Cogusue/Testador_de_AMP-OP/Simulações e Kikad/README.md

# Informações
Esta pasta contem as simulações e o o arquivo Kikad do projeto, que contém o esquematico e PCB do circuito.
Dado o proteus não sendo um bom software para simular circuitos analogicos, não simulei o oscilador nele. Houve certos erros por conta das não idealidades do circuito, que não fariam sentido o uso no proteus.
