Cogusue/Testador_de_AMP-OP/Imagens/README.md

# Informações
Estas são as imagens do esquematico e o flowchart do projeto.
Na pasta há imagens e videos das montagens.
