Cogusue/Testador_de_AMP-OP/Imagens/Read_Me.md

#Informações
Estas são as imagens e prints, feitas e tirados, durante o percurso do projeto.
