Cogusue/Testador_de_AMP-OP/(list of files, drawings)

Other design files:
Simulações e Kikad/Testador de Amp-OP (Sem Oscilador).pdsprj
