Cogusue/Testador_de_AMP-OP/Imagens/Montagem/README.md

# Informações
Fotos retiradas durante a montagem e e teste do projeto.
