Cogusue/Testador_de_AMP-OP/Imagens/Montagem/20220411_125517.jpg

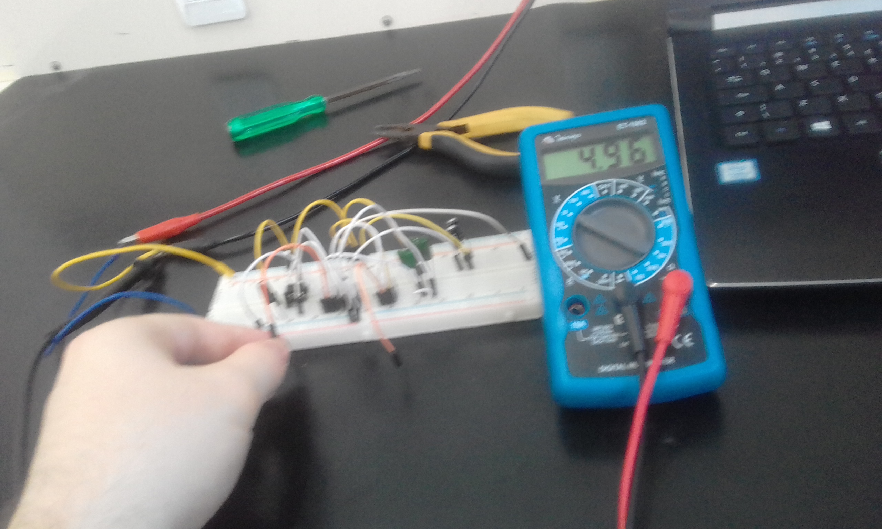
Imagens/Montagem/20220411_125517.jpg
