Cogusue/Testador_de_AMP-OP/Imagens/Montagem/20220411_125523.jpg

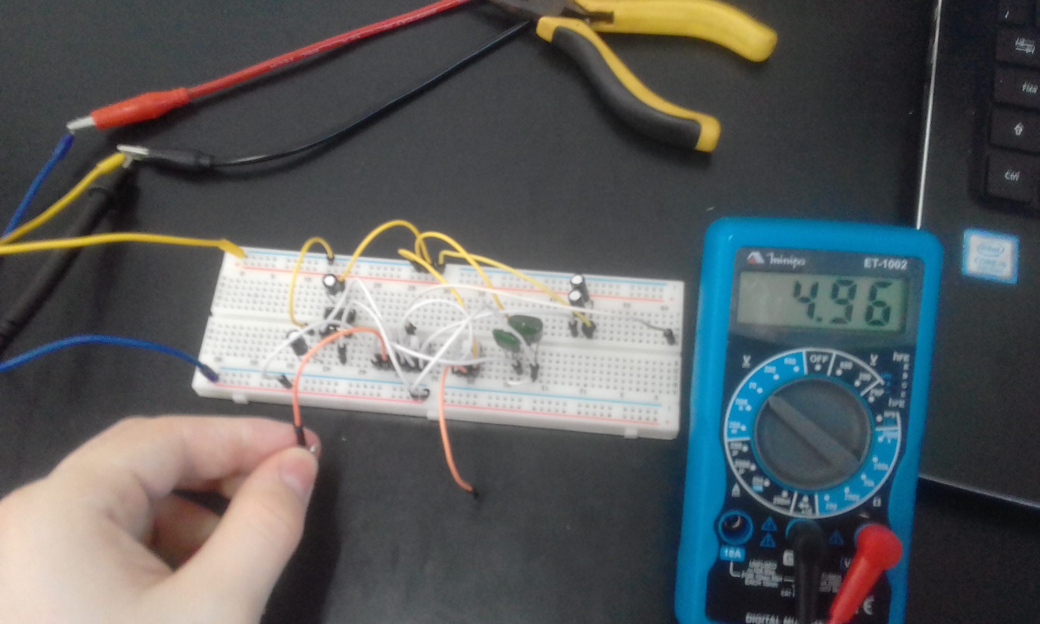
Imagens/Montagem/20220411_125523.jpg
