Cogusue/Testador_de_AMP-OP/Imagens/Montagem/20220427_115326.jpg

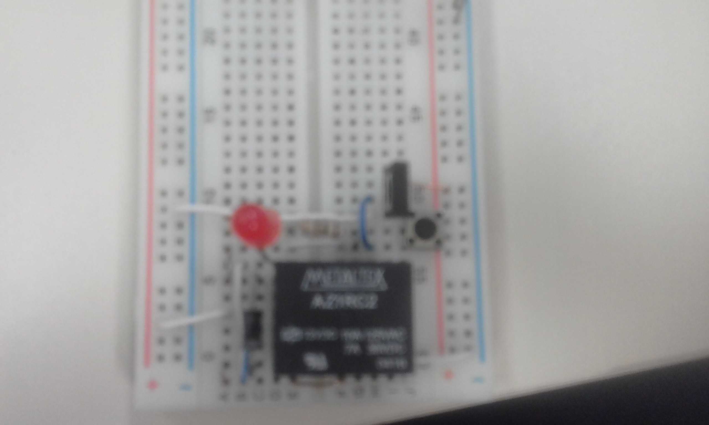
Imagens/Montagem/20220427_115326.jpg
