Cogusue/Testador_de_AMP-OP/Imagens/Montagem/20220427_115338.jpg

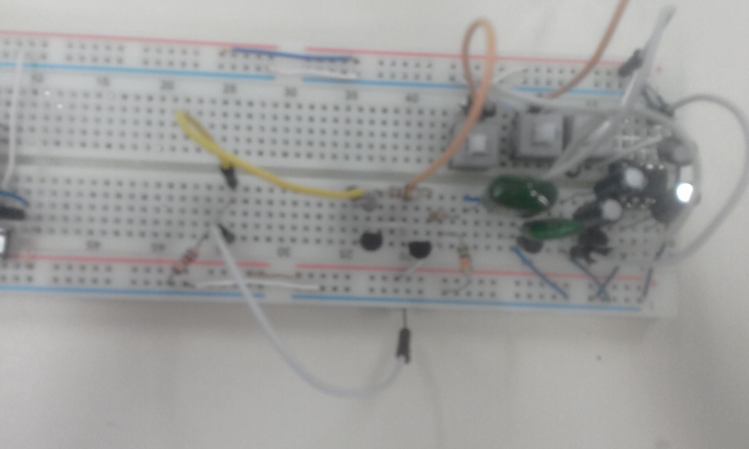
Imagens/Montagem/20220427_115338.jpg
