Cogusue/Testador_de_AMP-OP/Imagens/Montagem/20220427_115400.jpg

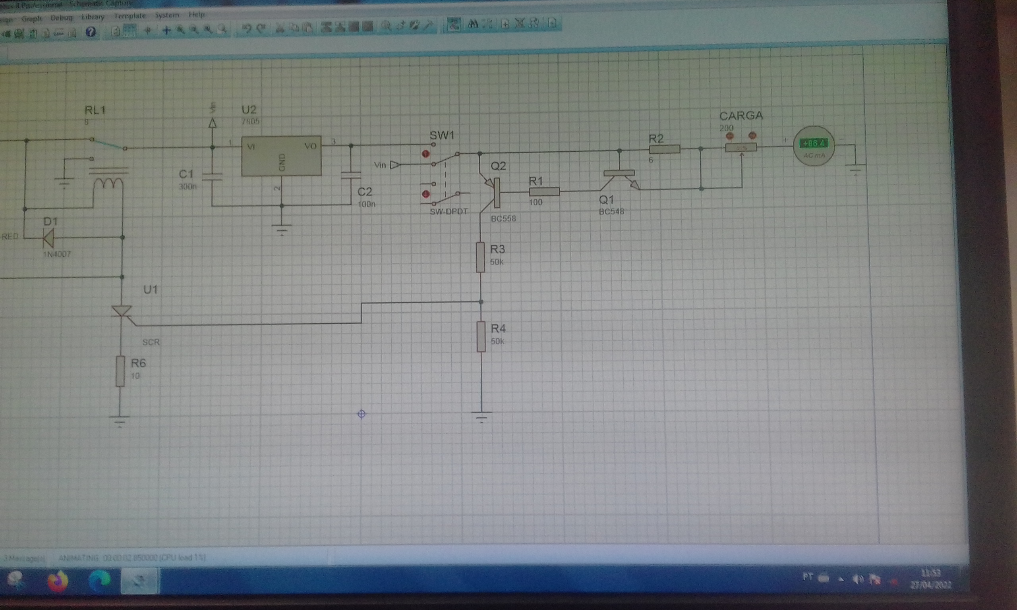
Imagens/Montagem/20220427_115400.jpg
