Cogusue/Testador_de_AMP-OP/Imagens/Montagem/20220503_115729.jpg

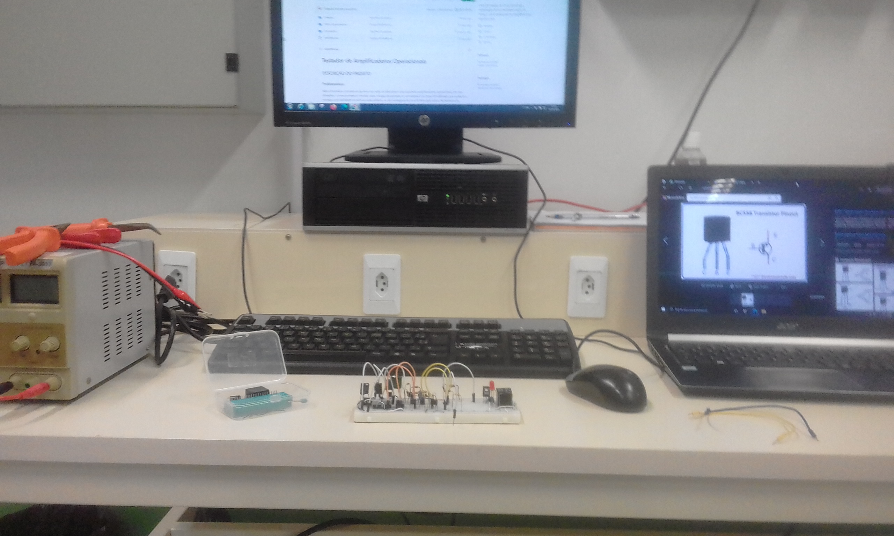
Imagens/Montagem/20220503_115729.jpg
