Cogusue/Testador_de_AMP-OP/Imagens/Montagem/20220517_095759.jpg

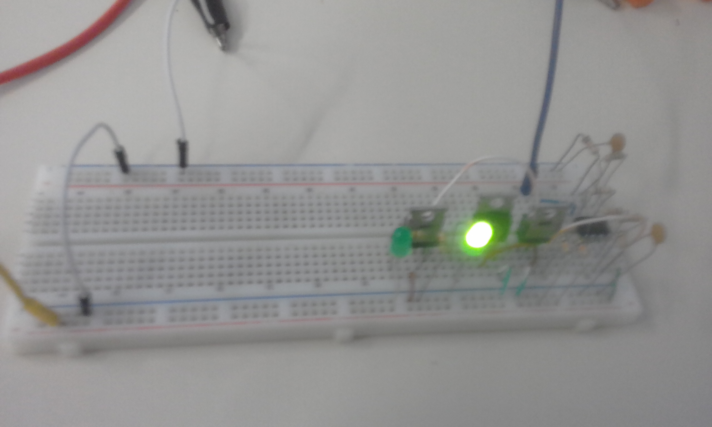
Imagens/Montagem/20220517_095759.jpg
