Cogusue/Testador_de_AMP-OP/Imagens/Montagem/20220517_095800.jpg

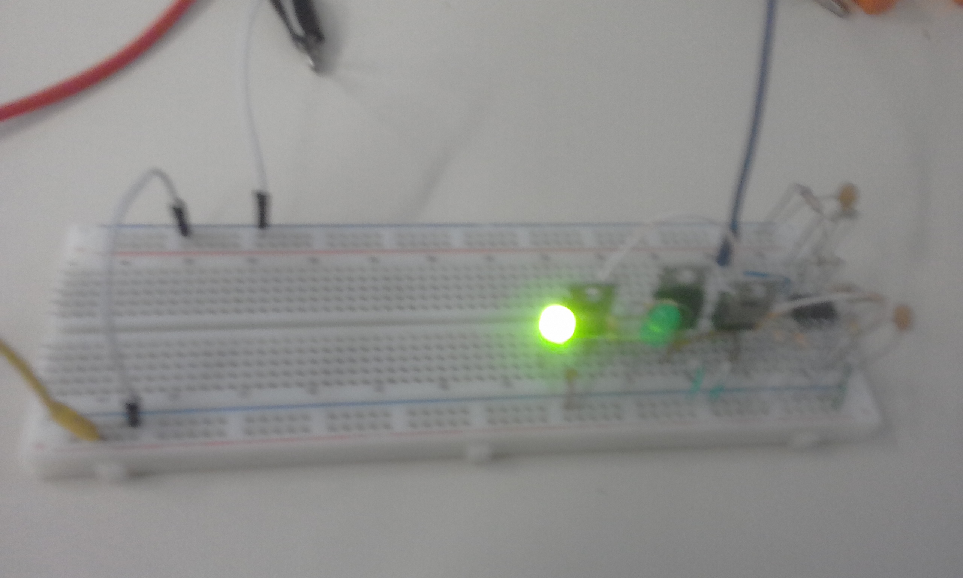
Imagens/Montagem/20220517_095800.jpg
