Cogusue/Testador_de_AMP-OP/Imagens/Montagem/20220517_095801.jpg

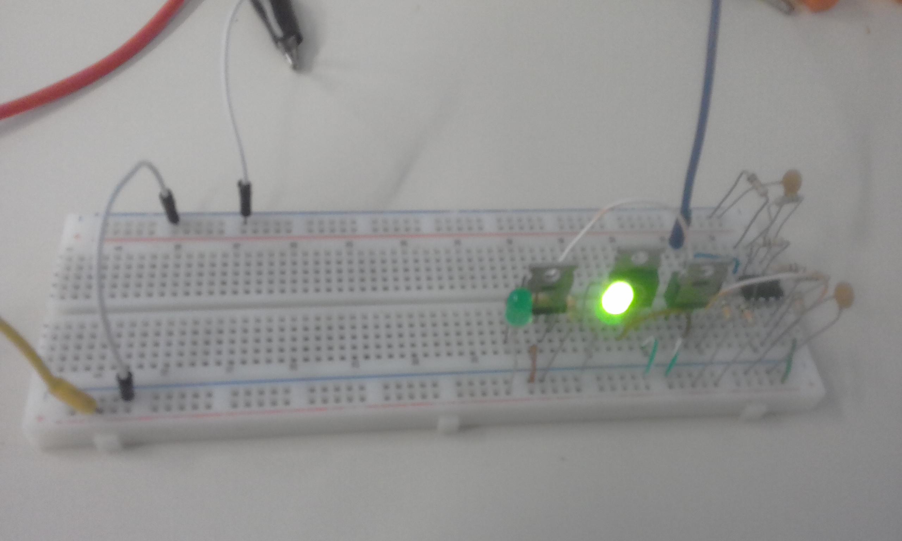
Imagens/Montagem/20220517_095801.jpg
