Cogusue/Testador_de_AMP-OP/Imagens/Montagem/20220517_095807.jpg

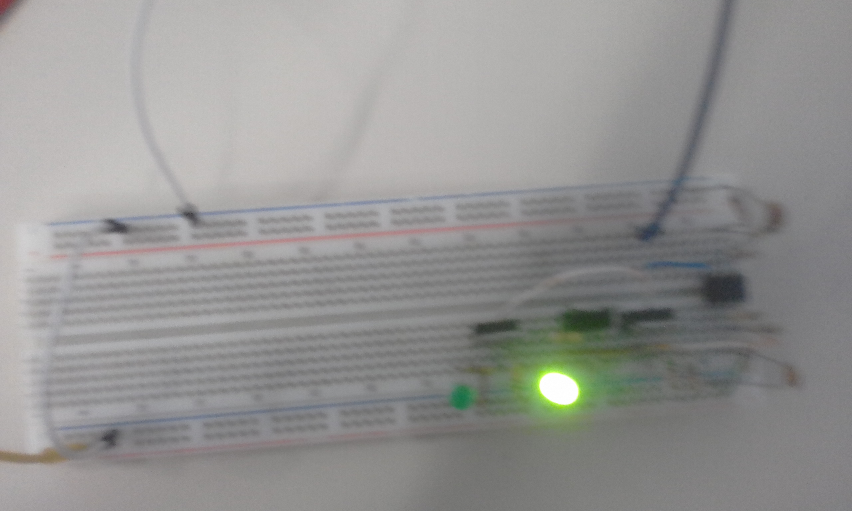
Imagens/Montagem/20220517_095807.jpg
