Cogusue/Testador_de_AMP-OP/Imagens/Montagem/20220517_100253.jpg

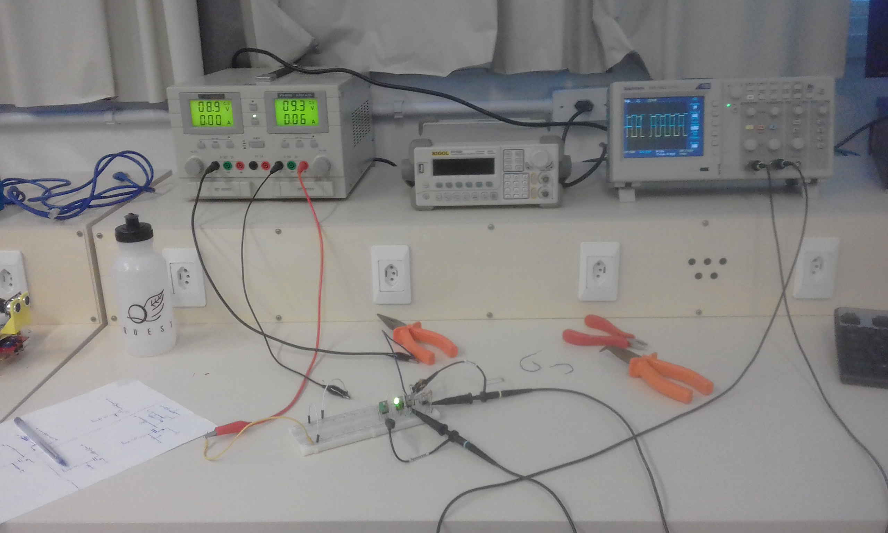
Imagens/Montagem/20220517_100253.jpg
