Cogusue/Testador_de_AMP-OP/Imagens/Montagem/20220517_100255.jpg

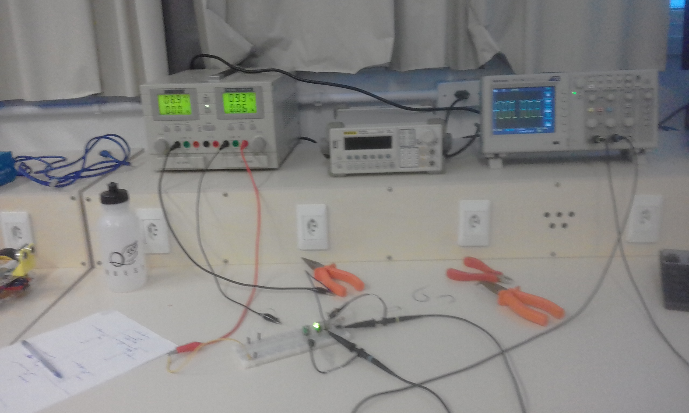
Imagens/Montagem/20220517_100255.jpg
