Cogusue/Testador_de_AMP-OP/Imagens/Montagem/20220603_123336.jpg

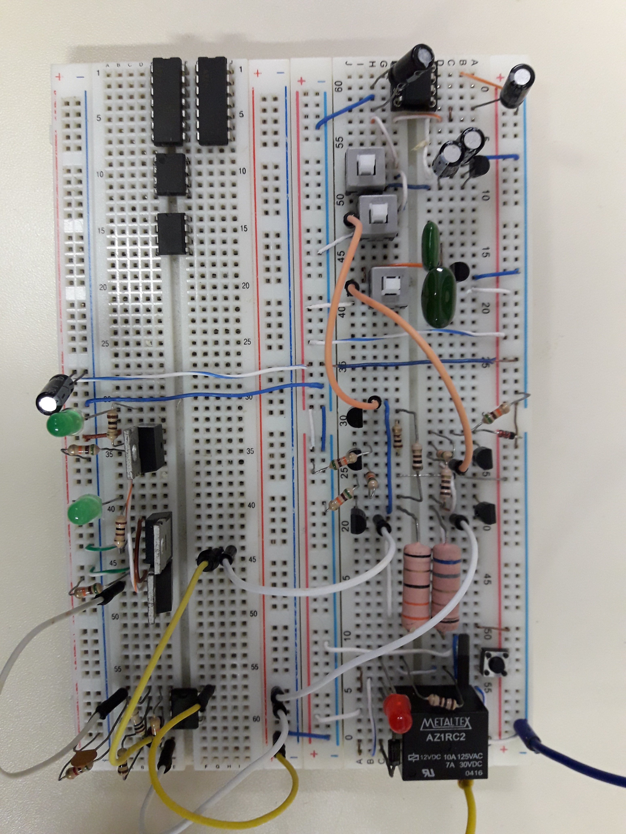
Imagens/Montagem/20220603_123336.jpg
